Bjoshua25/AI-Voice-Assistance-and-Playback/images/pcd_and_3d.jpg

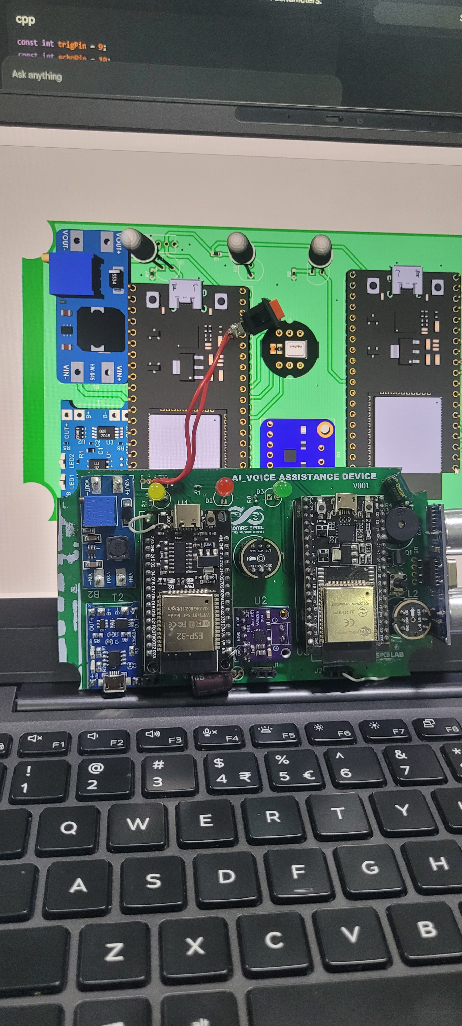
images/pcd_and_3d.jpg
