Bjoshua25/AI-Voice-Assistance-and-Playback/images/schematics_image.png

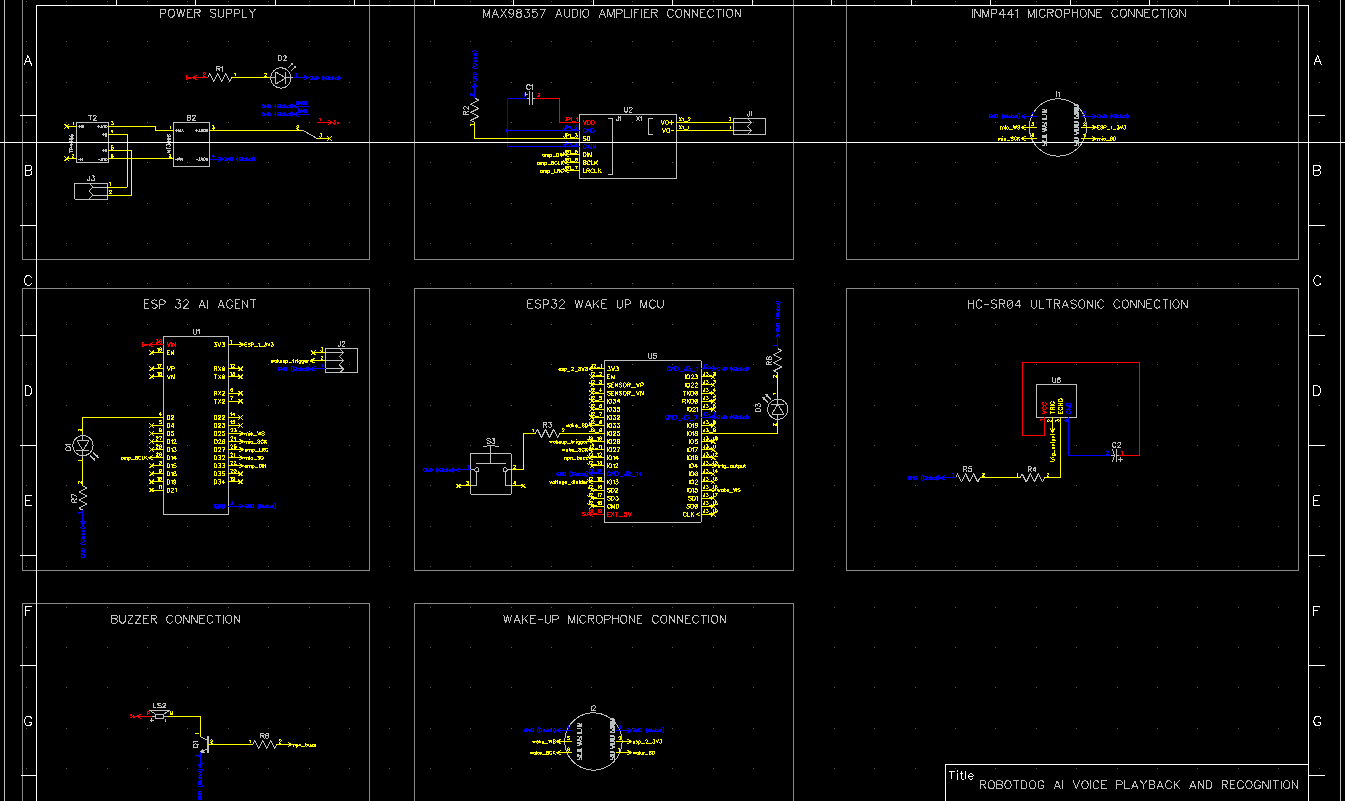
images/schematics_image.png
