Bjoshua25/AI-Voice-Assistance-and-Playback/schematics/main_schematics.pdf

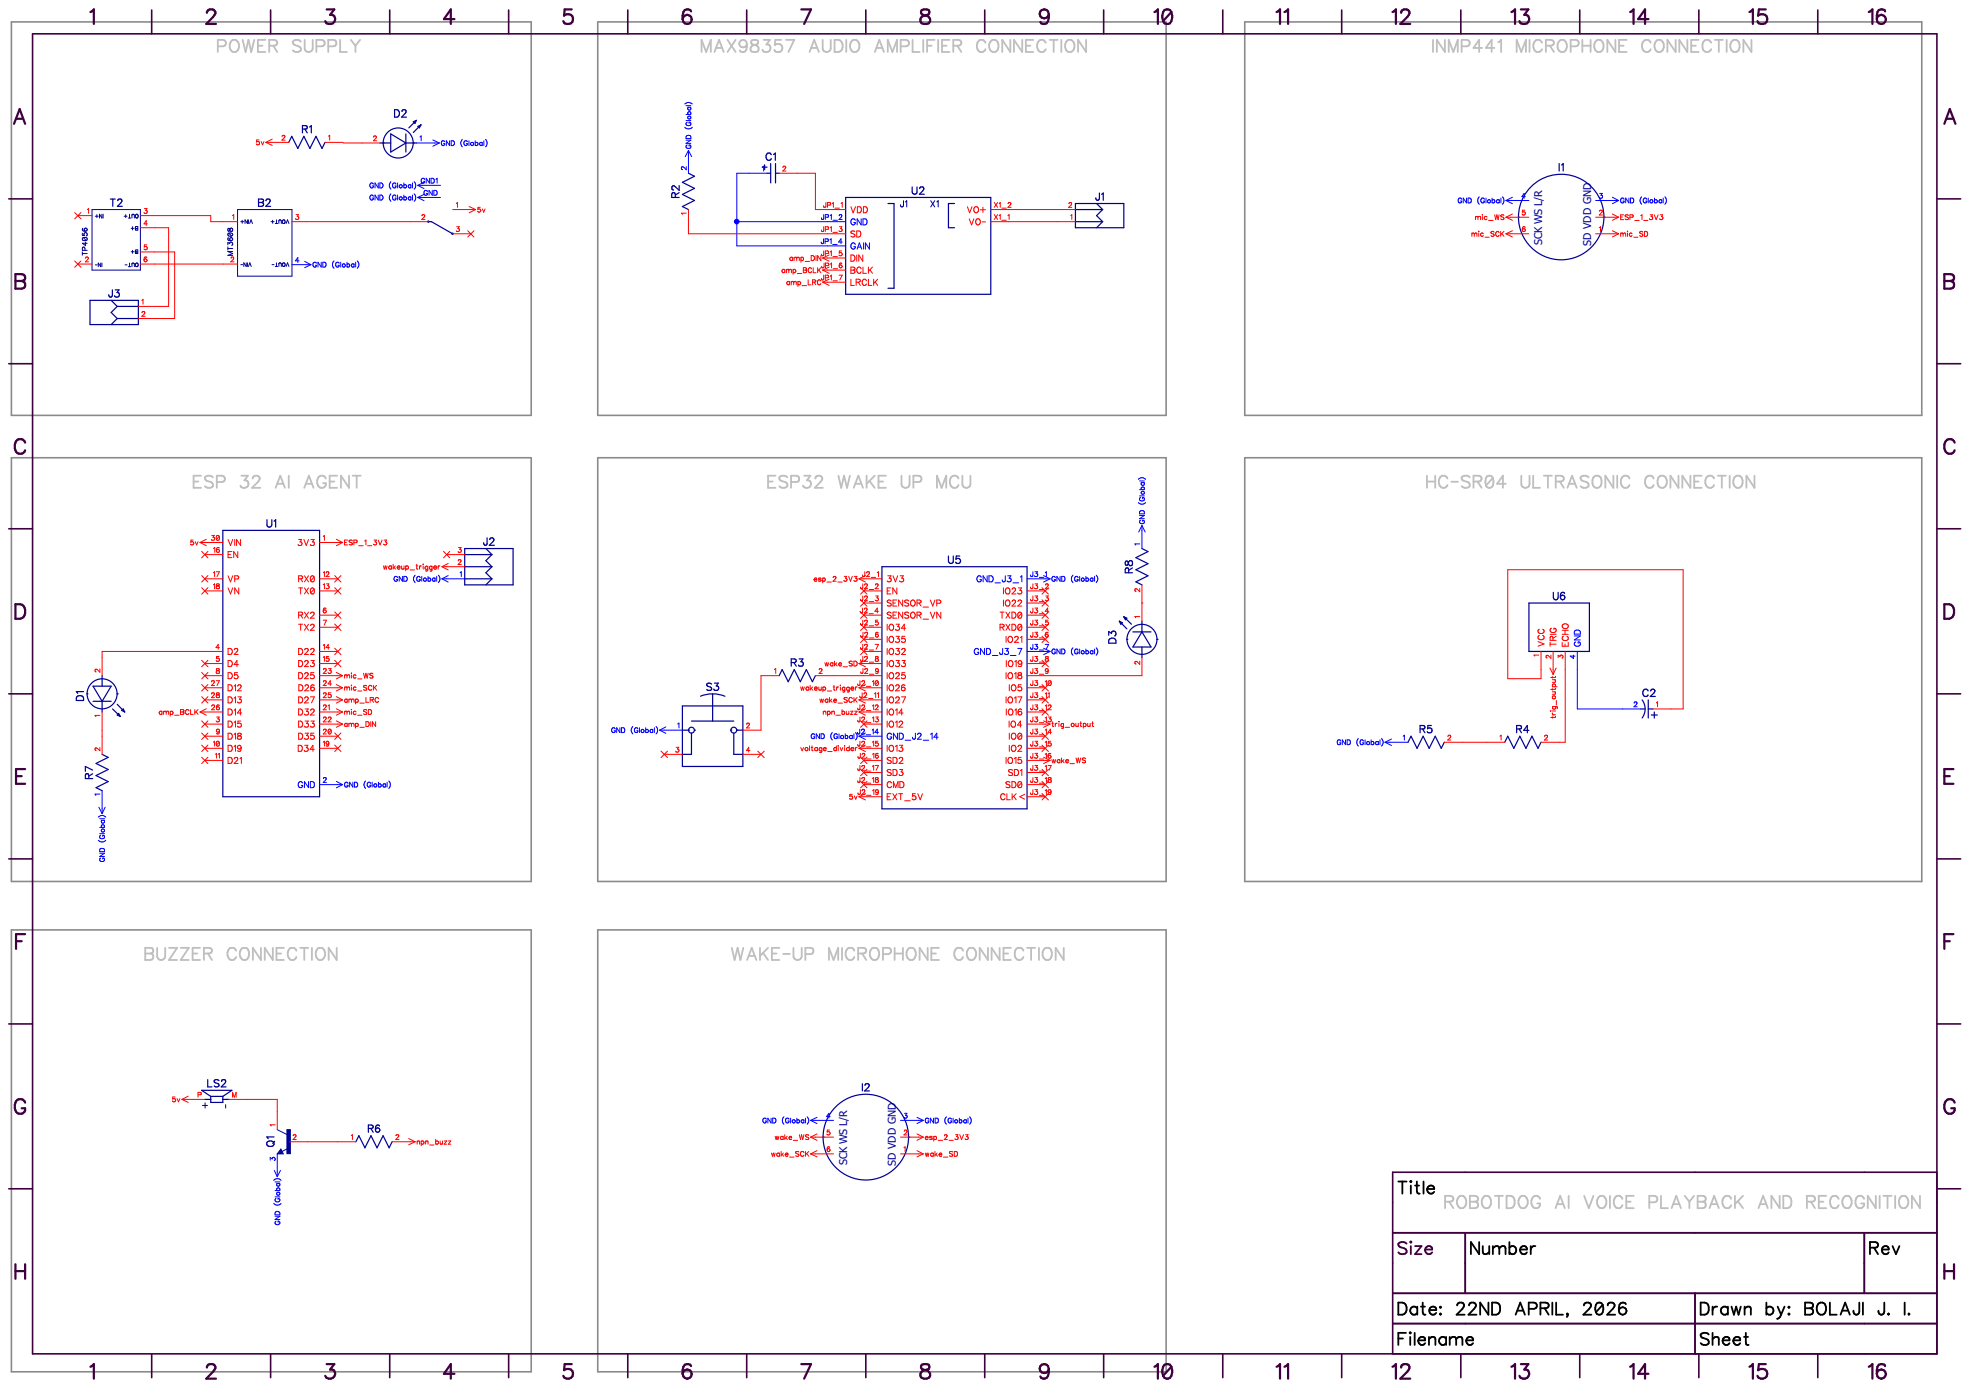
[picture p26: page 1]
