Bjoshua25/AI-Voice-Assistance-and-Playback/(list of files, drawings)

Other design files:
schematics/ai_voice_assistance_pdb_V1.dip
schematics/main_schematics.dch
