Bjoshua25/AI-Voice-Assistance-and-Playback/images/printed_pcb_mounted.jpg

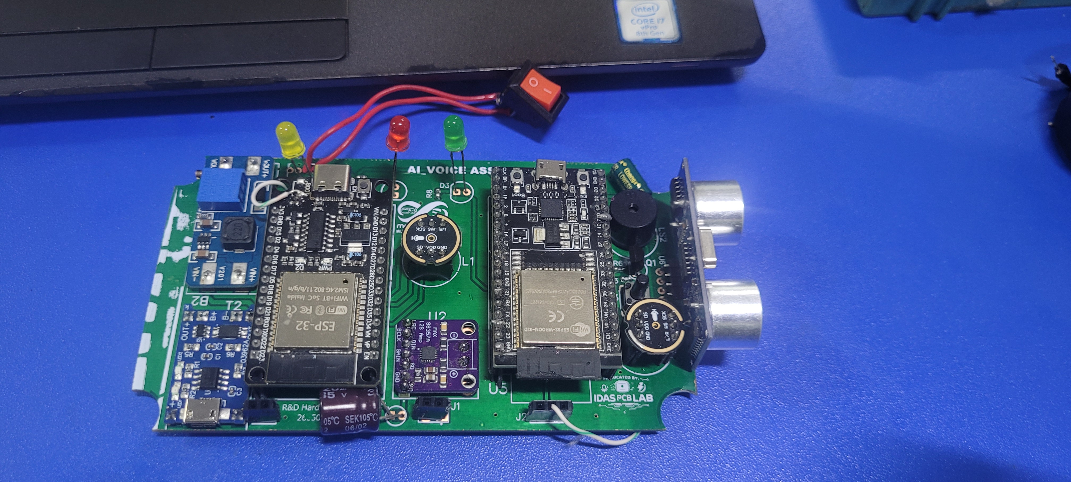
images/printed_pcb_mounted.jpg
