Bjoshua25/AI-Voice-Assistance-and-Playback/firmware/speech_transcription/speech_transcription.ino

#include <Arduino.h>
#include <WiFi.h>
#include <WiFiClientSecure.h>
#include <driver/i2s.h>
#include <ArduinoJson.h>

// --- Configuration ---
const char* ssid = "Godwin";
const char* password = "iiiiiiii";
const char* wit_token = "5UMB2NTKO7IAFFESKLO5FHFSWOIKA5HL";

#define I2S_SCK  14
#define I2S_WS   33
#define I2S_SD   32
#define I2S_PORT I2S_NUM_0
#define RECORDING_LED 4
#define SAMPLE_RATE 16000
#define CHUNK_SIZE 1024  

struct IntentResponse {
    String text;
    String intent;
    String entity_value;
    float confidence;
    int httpStatus;
};

WiFiClientSecure client;

void setupI2S() {
    const i2s_config_t i2s_config = {
        .mode = (i2s_mode_t)(I2S_MODE_MASTER | I2S_MODE_RX),
        .sample_rate = SAMPLE_RATE,
        .bits_per_sample = I2S_BITS_PER_SAMPLE_16BIT, 
        .channel_format = I2S_CHANNEL_FMT_ONLY_LEFT,
        .communication_format = I2S_COMM_FORMAT_STAND_I2S, 
        .intr_alloc_flags = ESP_INTR_FLAG_LEVEL1,
        .dma_buf_count = 8,
        .dma_buf_len = 64,
        .use_apll = false
    };

    const i2s_pin_config_t pin_config = {
        .bck_io_num = I2S_SCK, 
        .ws_io_num = I2S_WS,
        .data_out_num = -1, 
        .data_in_num = I2S_SD
    };

    i2s_driver_install(I2S_PORT, &i2s_config, 0, NULL);
    i2s_set_pin(I2S_PORT, &pin_config);
}

void connectToWiFi() {
    Serial.print("Connecting to WiFi");
    WiFi.begin(ssid, password);
    while (WiFi.status() != WL_CONNECTED) { delay(500); Serial.print("."); }
    Serial.println("\nWiFi Connected!");
    client.setInsecure(); 
}

IntentResponse performRecognition() {
    IntentResponse result = {"", "None", "None", 0.0, 0};
    
    if (!client.connect("api.wit.ai", 443)) {
        Serial.println("Connection failed");
        return result;
    }

    digitalWrite(RECORDING_LED, HIGH); 
    Serial.println(">>> LISTENING...");

    client.println("POST /speech?v=20240304 HTTP/1.1");
    client.println("Host: api.wit.ai");
    client.printf("Authorization: Bearer %s\r\n", wit_token);
    client.println("Content-Type: audio/raw;encoding=signed-integer;bits=16;rate=16000;endian=little");
    client.println("Transfer-Encoding: chunked");
    client.println("Connection: close");
    client.println();

    unsigned long start_time = millis();
    int16_t i2s_buffer[CHUNK_SIZE];
    size_t bytes_read;

    // Stream for 4 seconds
    while (millis() - start_time < 4000) { 
        i2s_read(I2S_PORT, &i2s_buffer, sizeof(i2s_buffer), &bytes_read, portMAX_DELAY);
        if (bytes_read > 0) {
            client.printf("%X\r\n", bytes_read);
            client.write((uint8_t*)i2s_buffer, bytes_read);
            client.print("\r\n");
        }
    }

    client.print("0\r\n\r\n"); 
    digitalWrite(RECORDING_LED, LOW); 
    Serial.println(">>> PROCESSING...");

    // 1. Skip Headers
    unsigned long timeout = millis();
    while (client.connected() && millis() - timeout < 5000) {
        String line = client.readStringUntil('\n');
        if (line.startsWith("HTTP/1.1")) {
            result.httpStatus = line.substring(9, 12).toInt();
        }
        if (line == "\r") break; 
    }

    // 2. Continuous JSON Stream Parsing
    String jsonBuffer = "";
    int braceCount = 0;
    bool recordingJson = false;
    timeout = millis();

    while (millis() - timeout < 10000) { // 10 second total processing timeout
        while (client.available()) {
            char c = client.read();

            if (c == '{') {
                if (braceCount == 0) jsonBuffer = ""; 
                braceCount++;
                recordingJson = true;
            }

            if (recordingJson) jsonBuffer += c;

            if (c == '}') {
                braceCount--;
                if (braceCount == 0 && recordingJson) {
                    recordingJson = false;
                    
                    DynamicJsonDocument doc(4096);
                    DeserializationError error = deserializeJson(doc, jsonBuffer);

                    if (!error) {
                        // Capture text whenever it appears
                        if (doc.containsKey("text")) {
                            result.text = doc["text"].as<String>();
                        }

                        // Capture intent and entities
                        if (doc.containsKey("intents") && doc["intents"].size() > 0) {
                            result.intent = doc["intents"][0]["name"].as<String>();
                            result.confidence = doc["intents"][0]["confidence"].as<float>();
                            
                            JsonObject entities = doc["entities"].as<JsonObject>();
                            for (JsonPair p : entities) {
                                result.entity_value = p.value()[0]["value"].as<String>();
                                break; 
                            }
                        }

                        // Exit immediately if we get the Final marker
                        if (doc["is_final"].as<bool>() == true || doc["type"] == "FINAL_UNDERSTANDING") {
                            client.stop();
                            return result;
                        }
                    }
                    jsonBuffer = ""; 
                }
            }
            timeout = millis(); // Reset timeout as long as we are receiving data
        }
        if (!client.connected() && !client.available()) break;
        delay(1); 
    }

    client.stop();
    return result;
}

void setup() {
    Serial.begin(115200);
    pinMode(RECORDING_LED, OUTPUT);
    connectToWiFi();
    setupI2S();
    Serial.println("Ready. Send 'r' to record.");
}

void loop() {
    if (Serial.available() > 0) {
        char c = Serial.read();
        if (c == 'r') {
            IntentResponse resp = performRecognition();
            Serial.println("\n--- SPEECH RESULT ---");
            Serial.printf("HTTP Status: %d\n", resp.httpStatus);
            Serial.printf("Text: %s\n", resp.text.length() > 0 ? resp.text.c_str() : "[No Text Detected]");
            Serial.printf("Intent: %s (Score: %.2f)\n", resp.intent.c_str(), resp.confidence);
            Serial.printf("Entity Value: %s\n", resp.entity_value.c_str());
            Serial.println("----------------------\n");
        }
    }
}
