Bjoshua25/AI-Voice-Assistance-and-Playback/(commit log)

2026-05-20 adjust the repo to include the Xiaozhi codebase
    [16m.csv, 16m_c3.csv, 16m_custom_wakeword.csv, 16m_echoear.csv, 32m.csv, 4m.csv, 4m_esp-hi.csv, 8m.csv]
2026-07-29 Readme file update and schematics
